AuWeerachai/WARCapstoneProject2023/Sangiumpaisankij_Gripper_Solidworks/WARS gripper/Version 7/Assem7.SLDASM

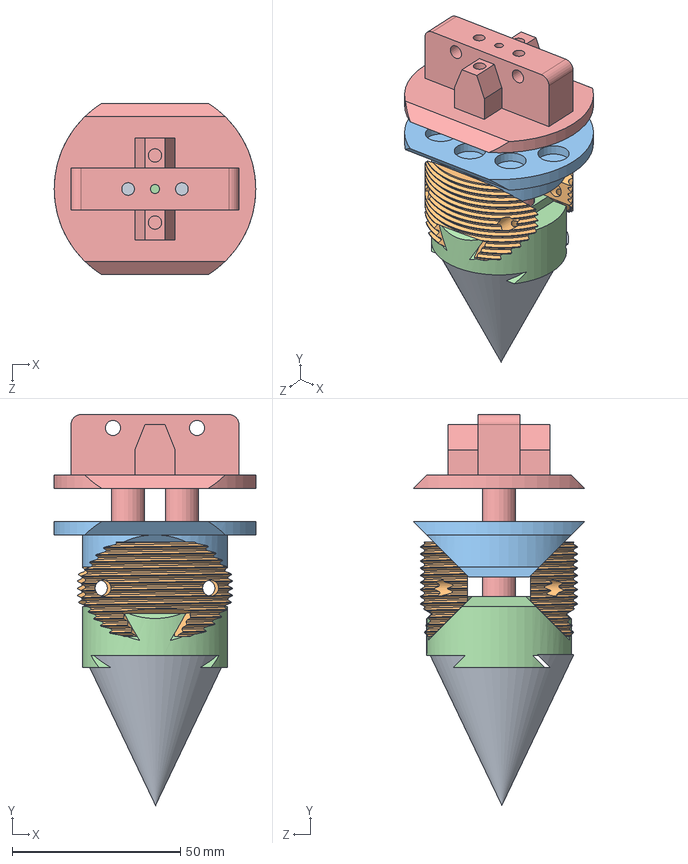
[picture p16: CAD file, 2025-01-04]
Sangiumpaisankij_Gripper_Solidworks/WARS gripper/Version 7/Assem7.SLDASM
60.0 x 116.3 x 51.0 mm
Top7
Bottom7
Middle7
Thread7 x 2
