AuWeerachai/WARCapstoneProject2023/Sangiumpaisankij_Gripper_Solidworks/WARS gripper/Version 7/Cone7.SLDPRT

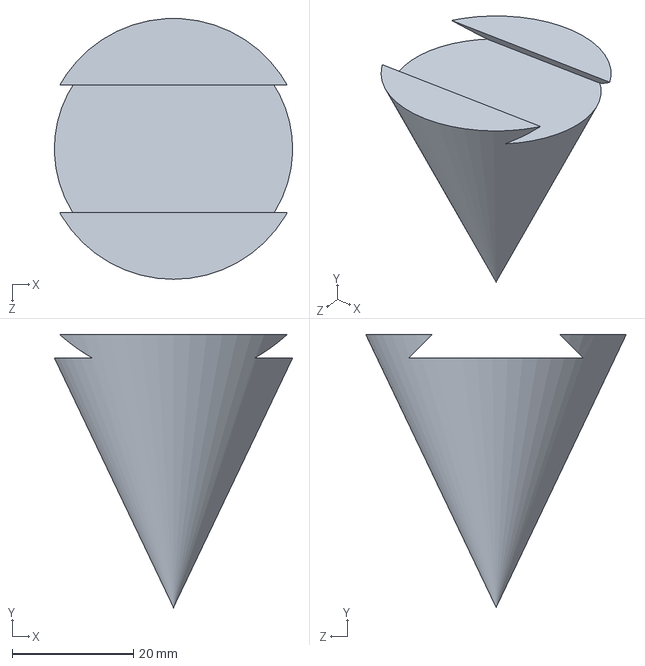
[picture p17: CAD file, 2025-01-04]
Sangiumpaisankij_Gripper_Solidworks/WARS gripper/Version 7/Cone7.SLDPRT
39.3 x 45.0 x 43.0 mm
