AuWeerachai/WARCapstoneProject2023/Sangiumpaisankij_Gripper_Solidworks/WARS gripper/Version 7/Top7.SLDPRT

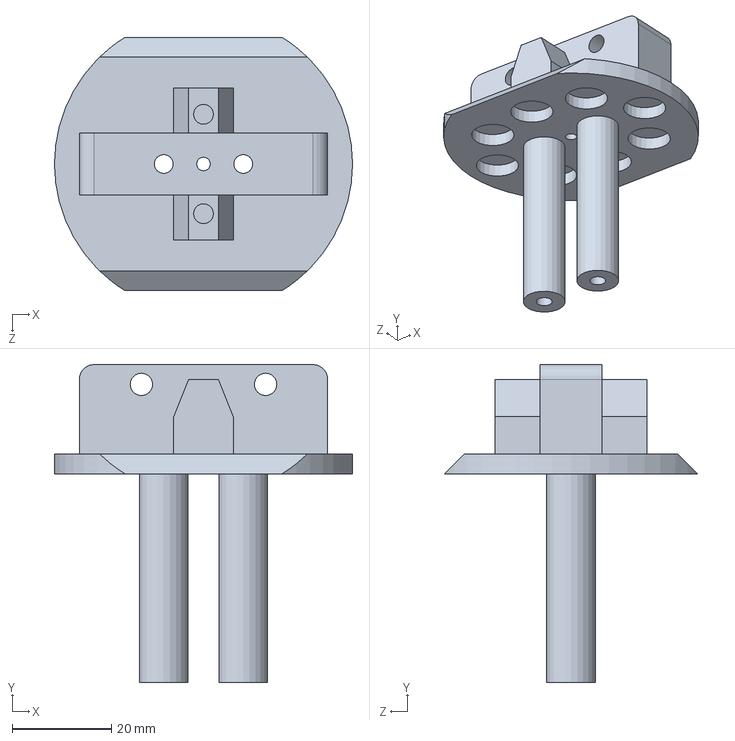
[picture p18: CAD file, 2025-01-04]
Sangiumpaisankij_Gripper_Solidworks/WARS gripper/Version 7/Top7.SLDPRT
60.0 x 64.0 x 51.0 mm
