AuWeerachai/WARCapstoneProject2023/Sangiumpaisankij_Gripper_Solidworks/WARS gripper/Version 7/Middle7.SLDPRT

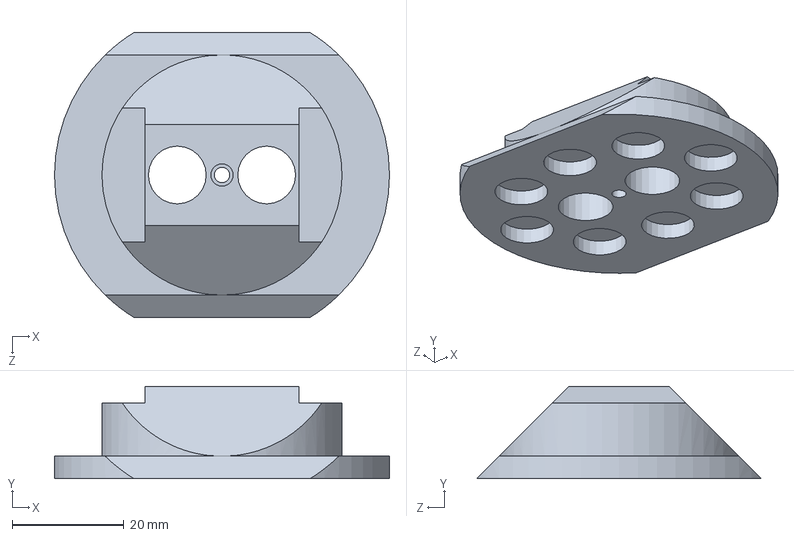
[picture p19: CAD file, 2025-01-04]
Sangiumpaisankij_Gripper_Solidworks/WARS gripper/Version 7/Middle7.SLDPRT
60.0 x 16.5 x 51.0 mm
