AuWeerachai/WARCapstoneProject2023/Sangiumpaisankij_Gripper_Solidworks/WARS gripper/Version 7/Thread7.SLDPRT

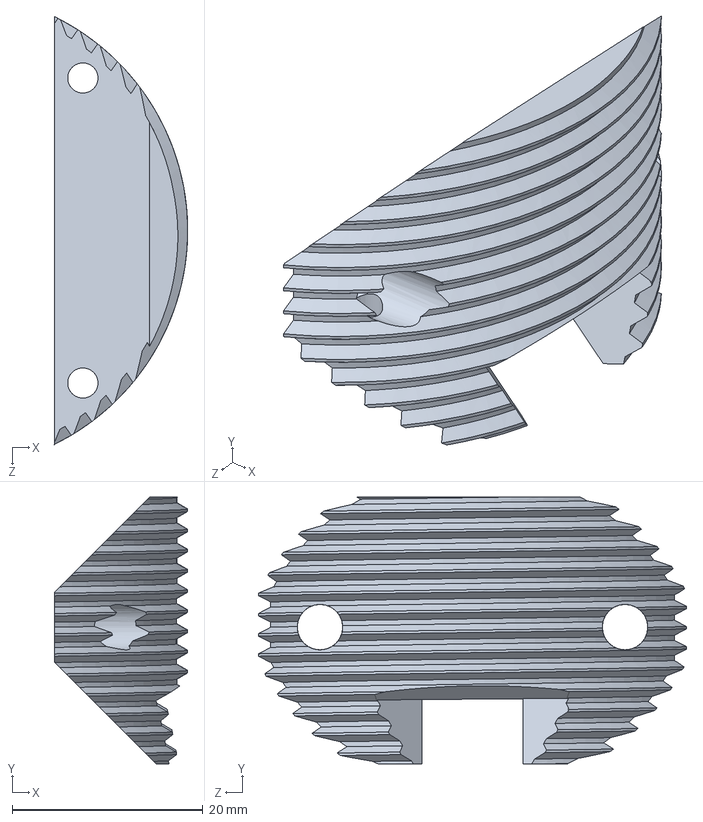
[picture p20: CAD file, 2025-01-04]
Sangiumpaisankij_Gripper_Solidworks/WARS gripper/Version 7/Thread7.SLDPRT
14.0 x 28.0 x 44.9 mm
