AuWeerachai/WARCapstoneProject2023/Sangiumpaisankij_Gripper_Solidworks/WARS gripper/Version 7/Bottom7.SLDPRT

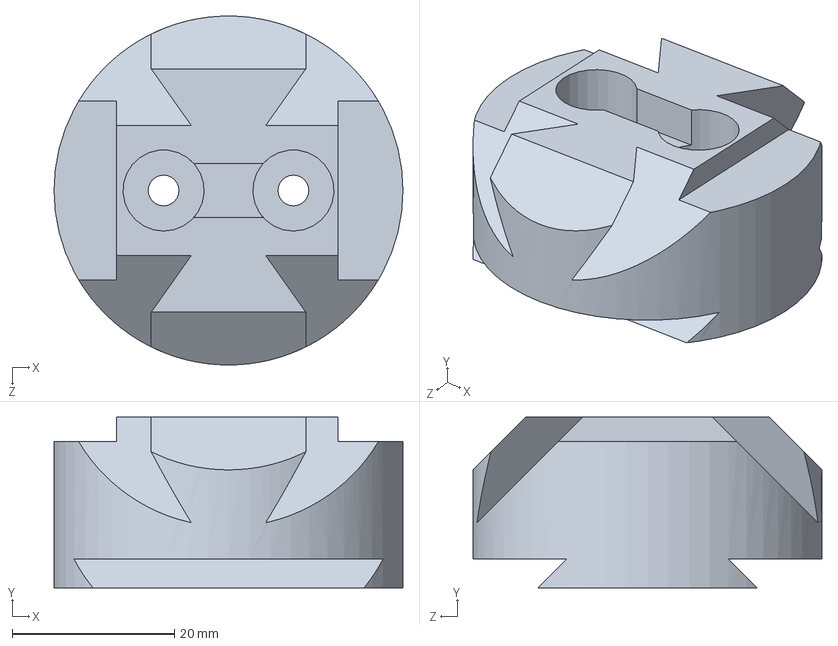
[picture p21: CAD file, 2025-01-04]
Sangiumpaisankij_Gripper_Solidworks/WARS gripper/Version 7/Bottom7.SLDPRT
43.0 x 21.0 x 43.0 mm
