AuWeerachai/WARCapstoneProject2023/Sangiumpaisankij_Gripper_Solidworks/WARS gripper/Version 3/Assem3.SLDASM

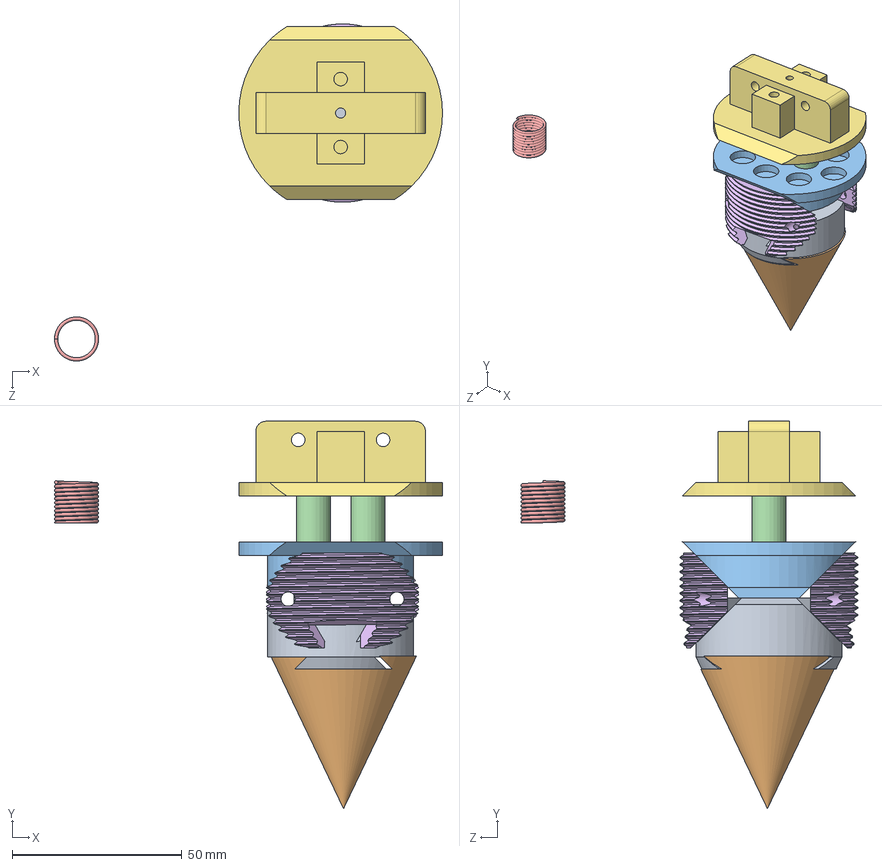
[picture p22: CAD file, 2025-01-04, an earlier design]
Sangiumpaisankij_Gripper_Solidworks/WARS gripper/Version 3/Assem3.SLDASM
114.3 x 114.1 x 99.3 mm
Bottom3
Middle3
Pole3 x 2
Spring3
Thread3 x 2
Top3
