AuWeerachai/WARCapstoneProject2023/Sangiumpaisankij_Gripper_Solidworks/WARS gripper/Version 2/Assem2.SLDASM

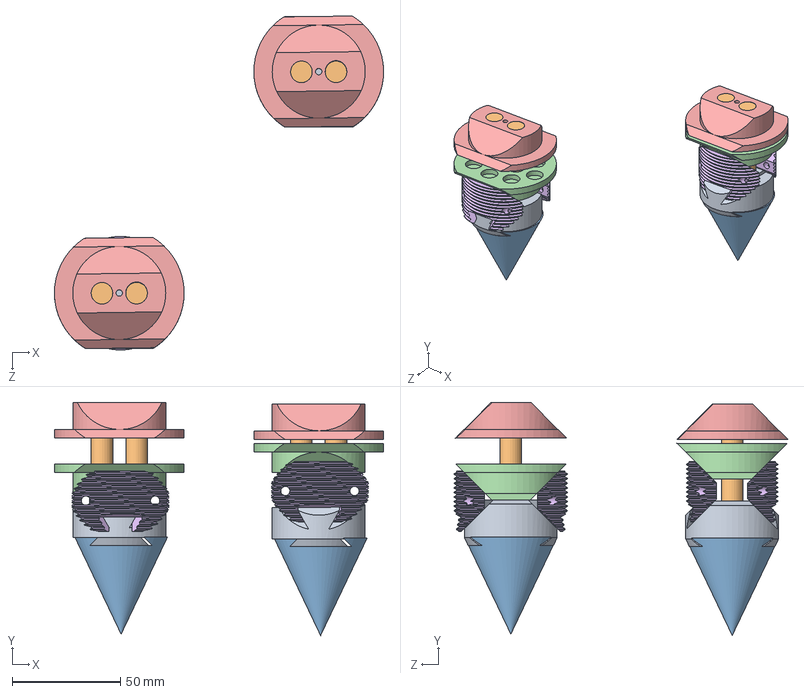
[picture p23: CAD file, 2025-01-04, an earlier design]
Sangiumpaisankij_Gripper_Solidworks/WARS gripper/Version 2/Assem2.SLDASM
152.2 x 107.8 x 154.4 mm
Bottom2 x 2
Pole2 x 4
Middle2 x 2
Top2 x 2
Thread2 x 4
