AuWeerachai/WARCapstoneProject2023/Sangiumpaisankij_Gripper_Solidworks/WARS gripper/Version 1/Bottom for tensile system.SLDPRT

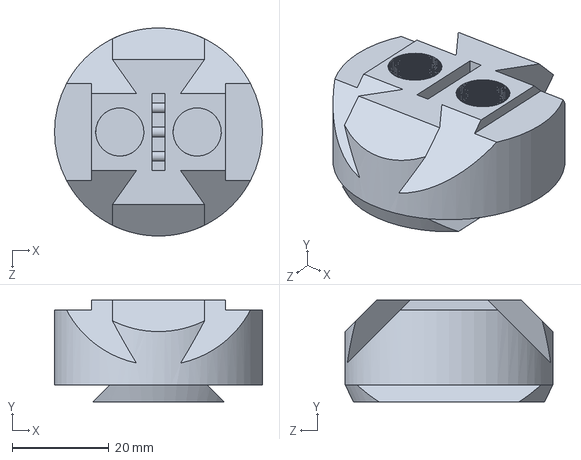
[picture p24: CAD file, 2025-01-04, an earlier design]
Sangiumpaisankij_Gripper_Solidworks/WARS gripper/Version 1/Bottom for tensile system.SLDPRT
43.0 x 21.0 x 43.0 mm
