AuWeerachai/WARCapstoneProject2023/Sangiumpaisankij_Gripper_Solidworks/WARS gripper/Version 2/Bottom2.SLDPRT

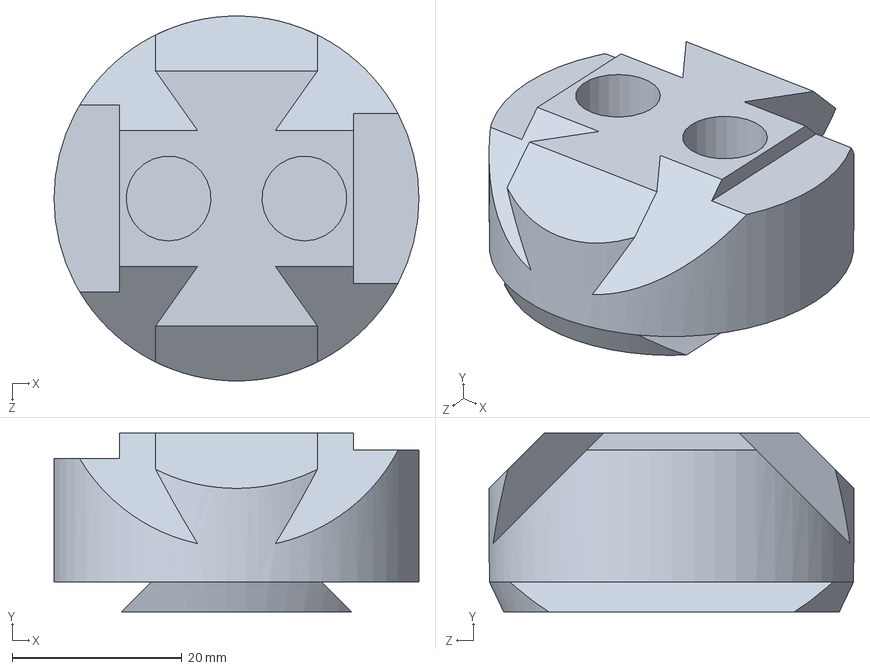
[picture p25: CAD file, 2025-01-04, an earlier design]
Sangiumpaisankij_Gripper_Solidworks/WARS gripper/Version 2/Bottom2.SLDPRT
43.0 x 21.0 x 43.0 mm
