AuWeerachai/WARCapstoneProject2023/Sangiumpaisankij_Gripper_Solidworks/WARS gripper/Version 1/Pole.SLDPRT

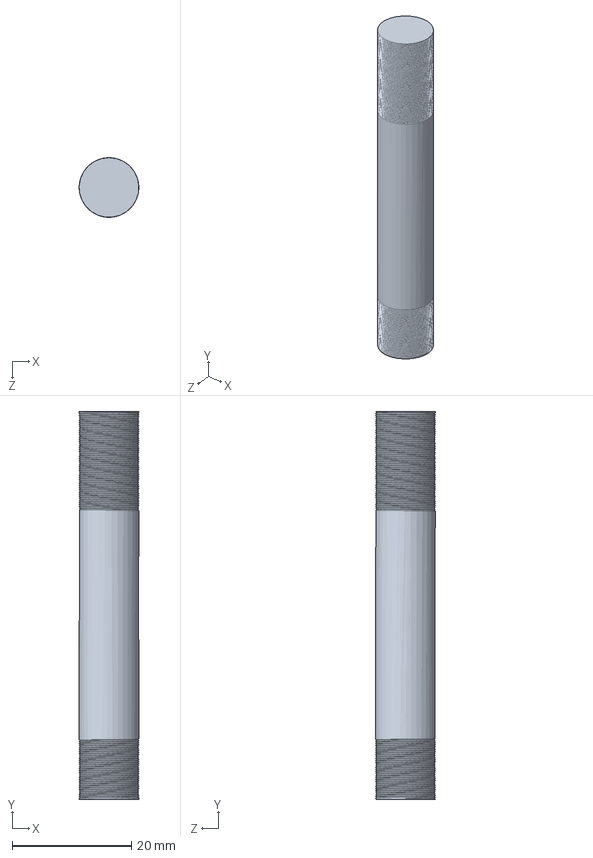
[picture p26: CAD file, 2025-01-04, an earlier design]
Sangiumpaisankij_Gripper_Solidworks/WARS gripper/Version 1/Pole.SLDPRT
10.0 x 65.0 x 10.0 mm
