AuWeerachai/WARCapstoneProject2023/Sangiumpaisankij_Gripper_Solidworks/WARS gripper/Version 3/Top3.SLDPRT

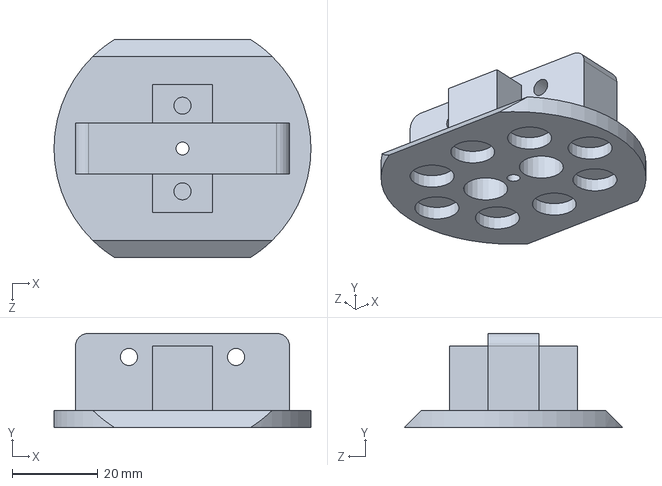
[picture p27: CAD file, 2025-01-04, an earlier design]
Sangiumpaisankij_Gripper_Solidworks/WARS gripper/Version 3/Top3.SLDPRT
60.0 x 22.0 x 51.0 mm
