AuWeerachai/WARCapstoneProject2023/(list of files, cad)

Other CAD files:
Sangiumpaisankij_Gripper_Solidworks/WARS gripper/Version 3/Thread3.SLDPRT
Sangiumpaisankij_Gripper_Solidworks/WARS gripper/Version 2/Middle2.SLDPRT
Sangiumpaisankij_Gripper_Solidworks/WARS gripper/Version 4/Thread4.SLDPRT
Sangiumpaisankij_Gripper_Solidworks/WARS gripper/Version 1/Bottom for compression system.SLDPRT
Sangiumpaisankij_Gripper_Solidworks/WARS gripper/Version 1/Cone.SLDPRT
Sangiumpaisankij_Gripper_Solidworks/WARS gripper/Version 1/Moving middle for compressed system.SLDPRT
Sangiumpaisankij_Gripper_Solidworks/WARS gripper/Version 1/Moving middle for tensile system.SLDPRT
Sangiumpaisankij_Gripper_Solidworks/WARS gripper/Version 1/Spring.SLDPRT
Sangiumpaisankij_Gripper_Solidworks/WARS gripper/Version 1/Top newcut.SLDPRT
Sangiumpaisankij_Gripper_Solidworks/WARS gripper/Version 1/V6 Threads 2023.SLDPRT
Sangiumpaisankij_Gripper_Solidworks/WARS gripper/Version 2/Cone2.SLDPRT
Sangiumpaisankij_Gripper_Solidworks/WARS gripper/Version 2/Pole2.SLDPRT
Sangiumpaisankij_Gripper_Solidworks/WARS gripper/Version 2/Spring2.SLDPRT
Sangiumpaisankij_Gripper_Solidworks/WARS gripper/Version 2/Thread2.SLDPRT
Sangiumpaisankij_Gripper_Solidworks/WARS gripper/Version 2/Top2.SLDPRT
Sangiumpaisankij_Gripper_Solidworks/WARS gripper/Version 3/Bottom3.SLDPRT
Sangiumpaisankij_Gripper_Solidworks/WARS gripper/Version 3/Cone3.SLDPRT
Sangiumpaisankij_Gripper_Solidworks/WARS gripper/Version 3/Middle3.SLDPRT
Sangiumpaisankij_Gripper_Solidworks/WARS gripper/Version 3/Pole3.SLDPRT
Sangiumpaisankij_Gripper_Solidworks/WARS gripper/Version 3/Spring3.SLDPRT
Sangiumpaisankij_Gripper_Solidworks/WARS gripper/Version 4/Bottom4.SLDPRT
Sangiumpaisankij_Gripper_Solidworks/WARS gripper/Version 4/Middle4.SLDPRT
Sangiumpaisankij_Gripper_Solidworks/WARS gripper/Version 4/Top4.SLDPRT
Sangiumpaisankij_Gripper_Solidworks/WARS gripper/Version 5/Middle5.SLDPRT
Sangiumpaisankij_Gripper_Solidworks/WARS gripper/Version 5/Top5.SLDPRT
Sangiumpaisankij_Gripper_Solidworks/WARS gripper/Version 6/Top6.SLDPRT
